IAmPattycakes/AdvancedPrototypingHandheld/Pictures/IMG_20180402_155633.jpg

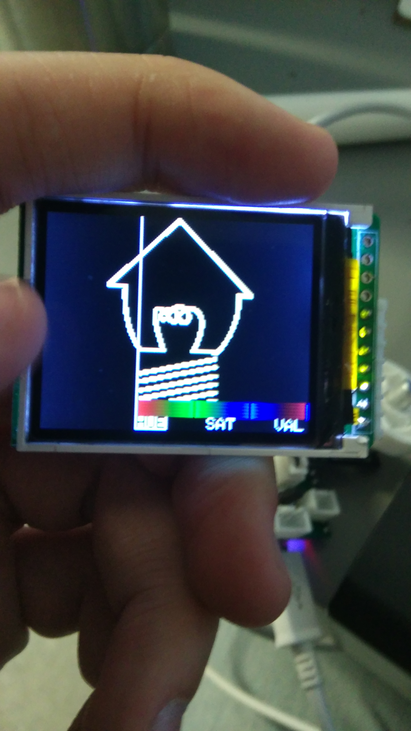
Pictures/IMG_20180402_155633.jpg
