IAmPattycakes/AdvancedPrototypingHandheld/README.txt

Hello World

This is a GitHub repository for the CRT 420 Advanced Prototyping Class
