IAmPattycakes/AdvancedPrototypingHandheld/Documentation/00 - Project Poster.pdf

# Photo-Home

# CRT 420 - Spring 2018

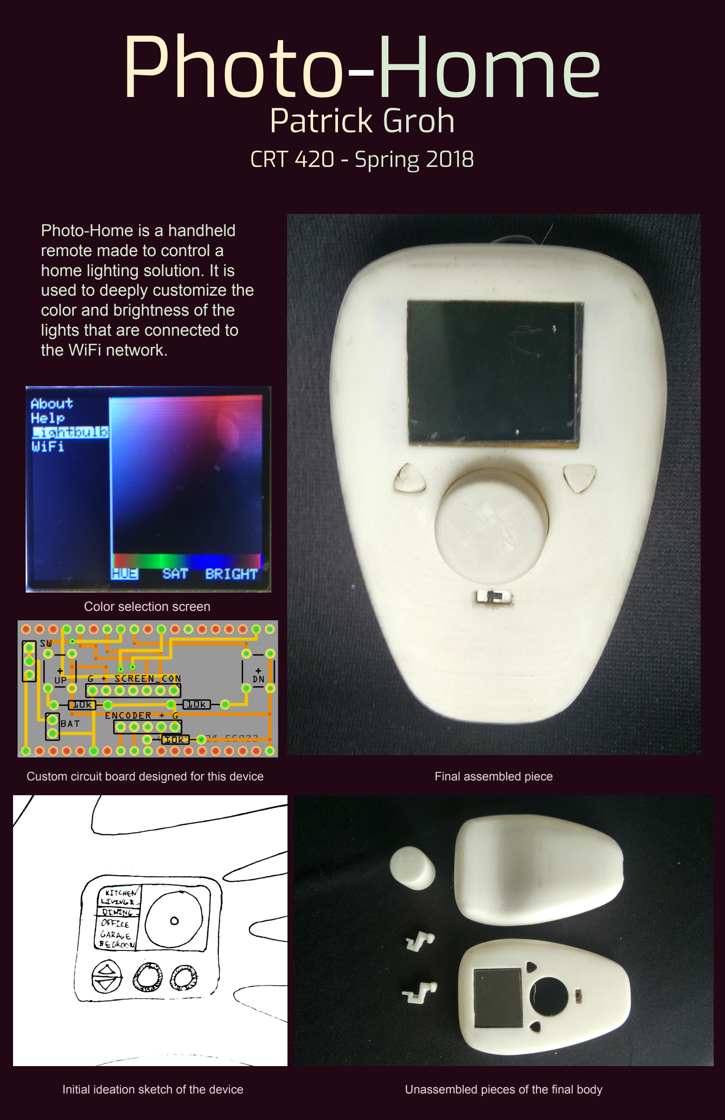
[picture p2: page 1]

Photo-Home is a handheld
remote made to control a
home lighting solution. It is used to deeply customize the color and brightness of the lights that are connected to the WiFi network.

# Patrick Groh

Color selection screen

Custom circuit board designed for this device

Initial ideation sketch of the device

Final assembled piece

Unassembled pieces of the final body
