IAmPattycakes/AdvancedPrototypingHandheld/Documentation/07 - Function Production.pdf

## Function Production

### Finalized Software

I have included the following libraries:
- RotaryEncoder by Matthias Hertel
- Adafruit GFX
- TFT_eSPI by Bodmer
- And the built in libraries:
- SPI
- EEPROM
- Wifi
- WifiMulti
- HTTPClient

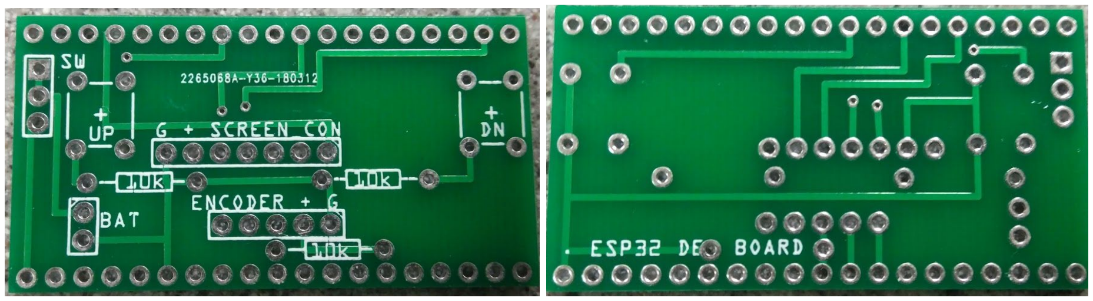
[picture p14: figure]
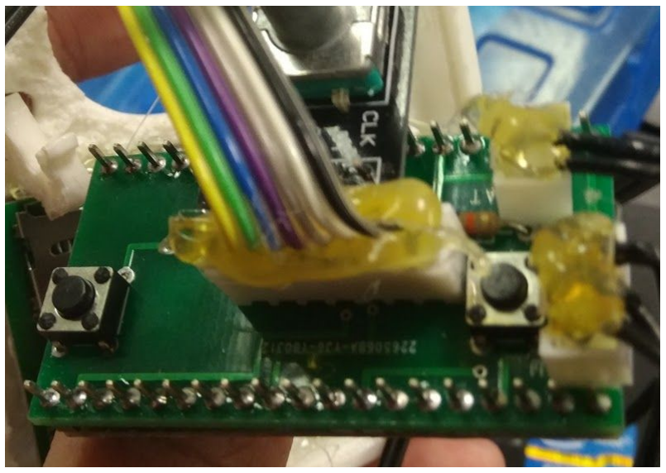
[picture p15: figure]
