IAmPattycakes/AdvancedPrototypingHandheld/Documentation/Pinups/Pinup III.pdf

# Pinup III

## Revenge of the pins

By Patrick Groh

## Board Overview

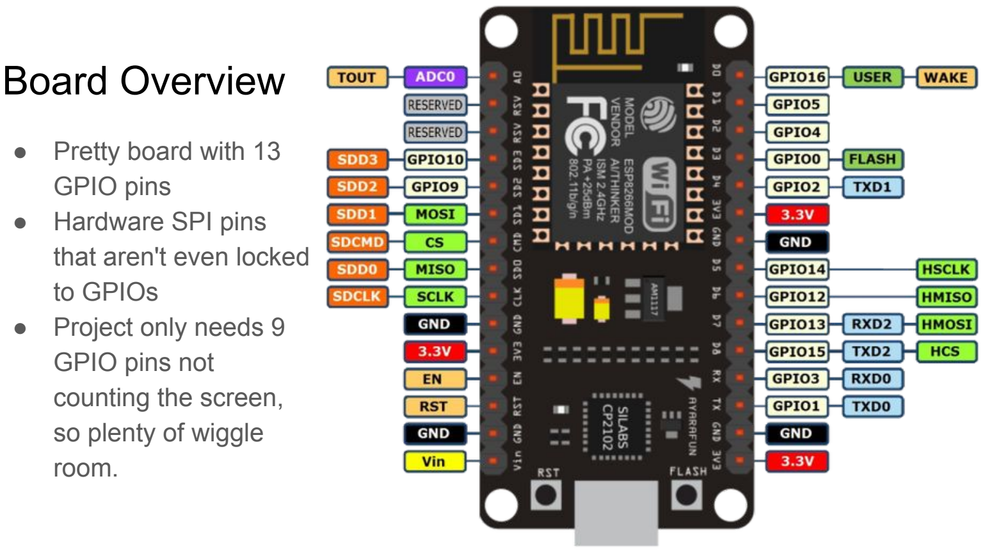
[picture p22: page 2]

- Pretty board with 13
GPIO pins
- Hardware SPI pins
that aren't even locked
to GPIOs
- Project only needs 9
GPIO pins not
counting the screen,
so plenty of wiggle
room.

## Updated board overview

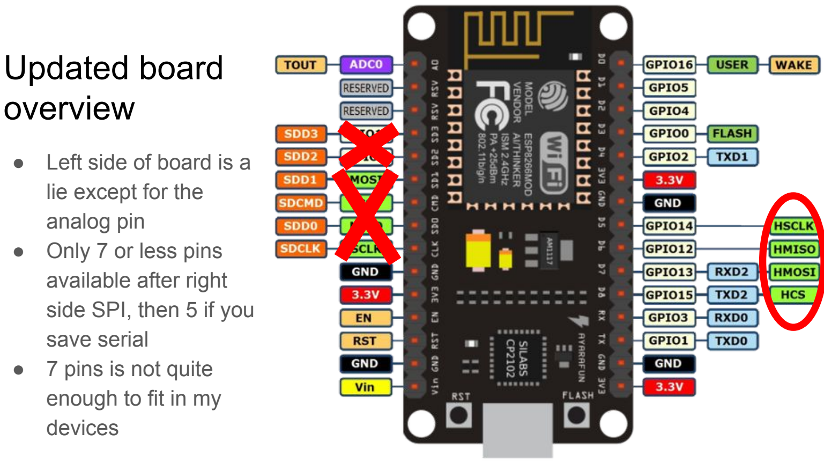
[picture p23: page 3]

- Left side of board is a
lie except for the
analog pin
- Only 7 or less pins
available after right
side SPI, then 5 if you
save serial
- 7 pins is not quite
enough to fit in my
devices

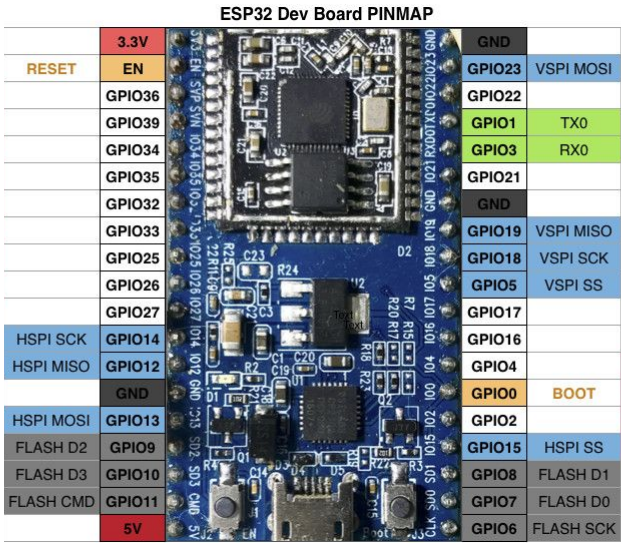
[picture p24: figure]

## Pinout of Replacement (hopefully)

- 15 GPIO pins that are not used for anything critical
- Has same wireless possibilities as ESP8266
- Still small enough to fit in a remote

## Other possibilities:

- Maybe multiplexing the encoders is possible. Maybe.
- Complete, un-user-friendly rework of the UI to save 2 pins
- Daughter board for the screen that drives it over serial cues

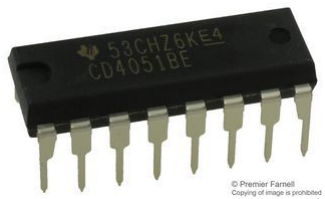
[picture p25: figure]

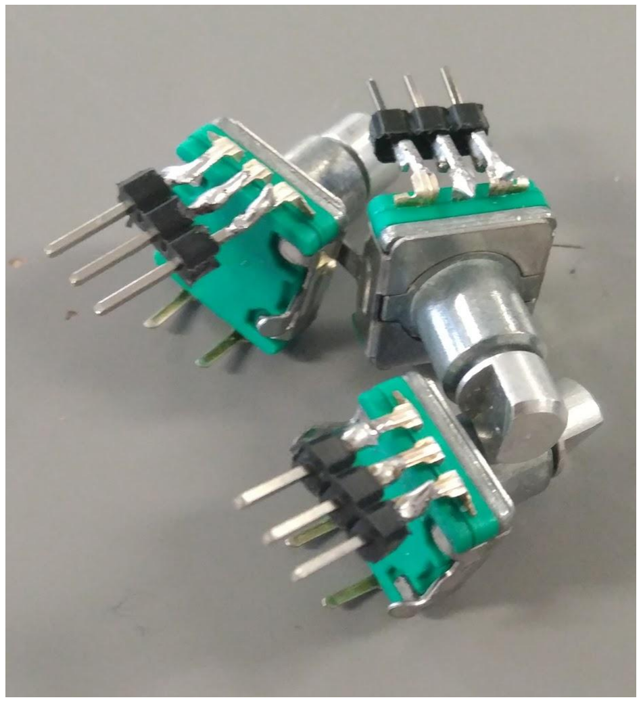
[picture p26: figure]

## Other things that have happened:

- Attempted to Hello World the smaller encoders (Failed)
- Attempted to Hello World web communication to and from the device (Great Success)
- Attempted to Hello World buttons (Success)
- Worked on the program to get things started for the interface
- Made pretty logo concept, to be refined.

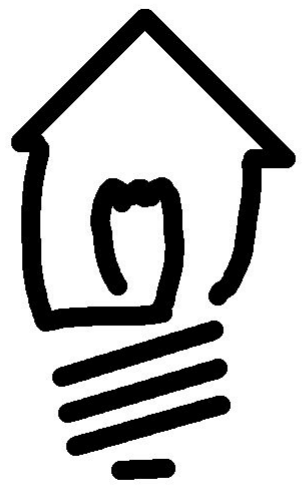
[picture p27: figure]

## Pretty monochrome logo

- Looks kinda like a lightbulb
- Looks kinda like a house
- Artsy
