IAmPattycakes/AdvancedPrototypingHandheld/Documentation/08- Form Production.pdf

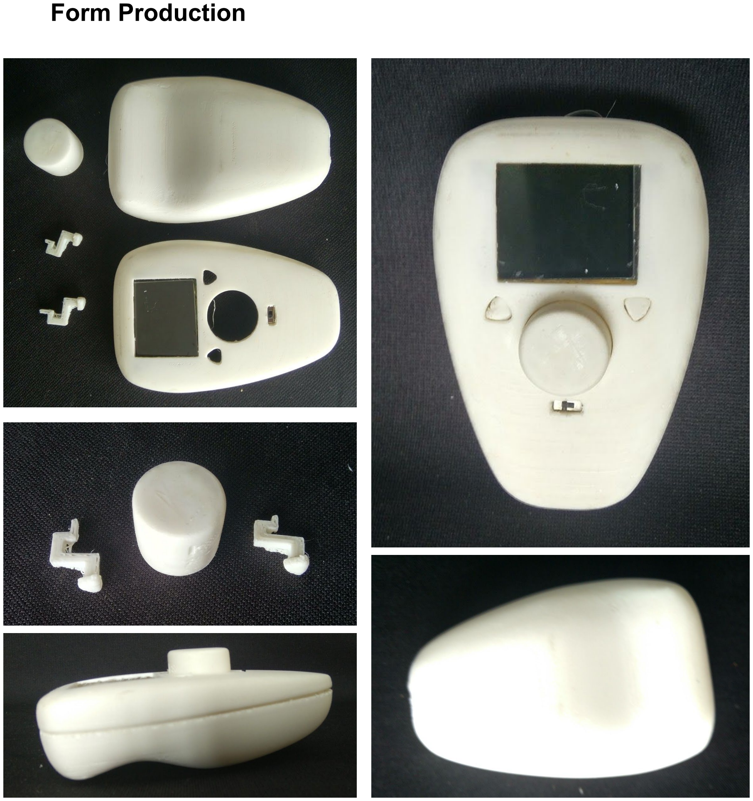
[picture p35: page 1]

Form Production
