IAmPattycakes/AdvancedPrototypingHandheld/Documentation/09-Finalization.pdf

### Finalization

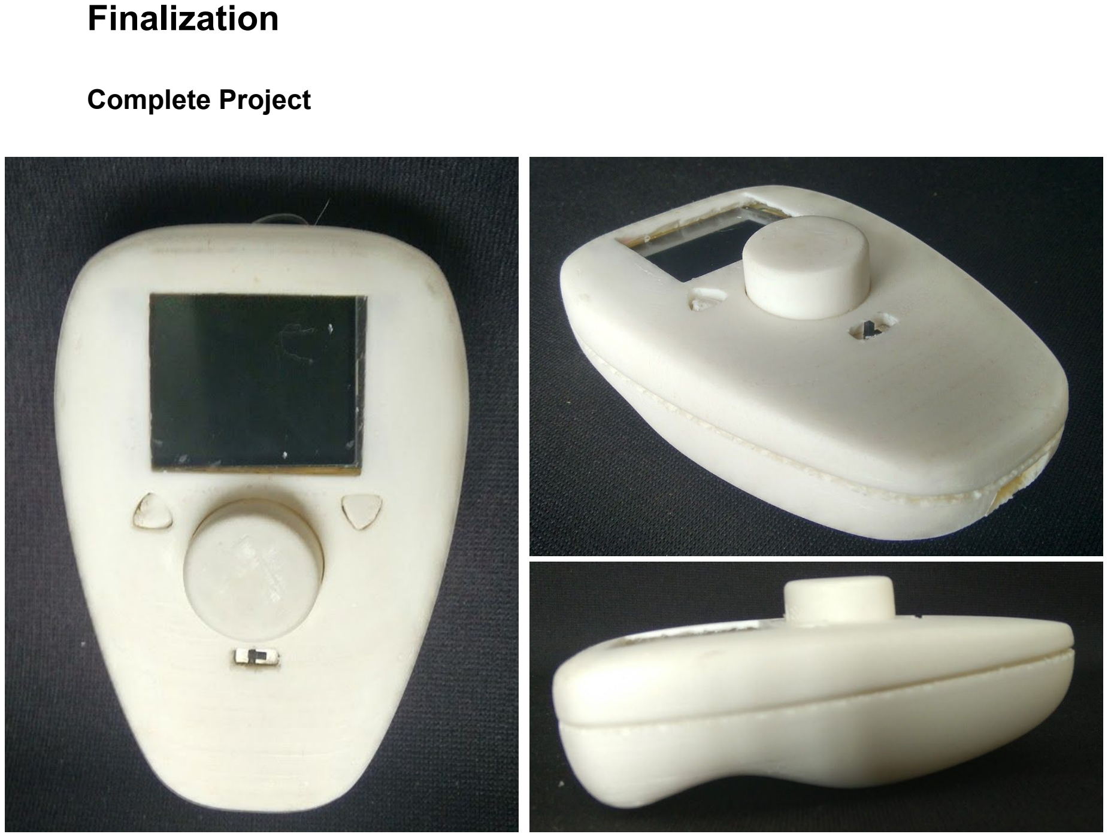
[picture p36: page 1]

Complete Project
