IAmPattycakes/AdvancedPrototypingHandheld/Documentation/06 - Form Proof.pdf

## Form Proof of Concept

Refined Dimensioned Sketches

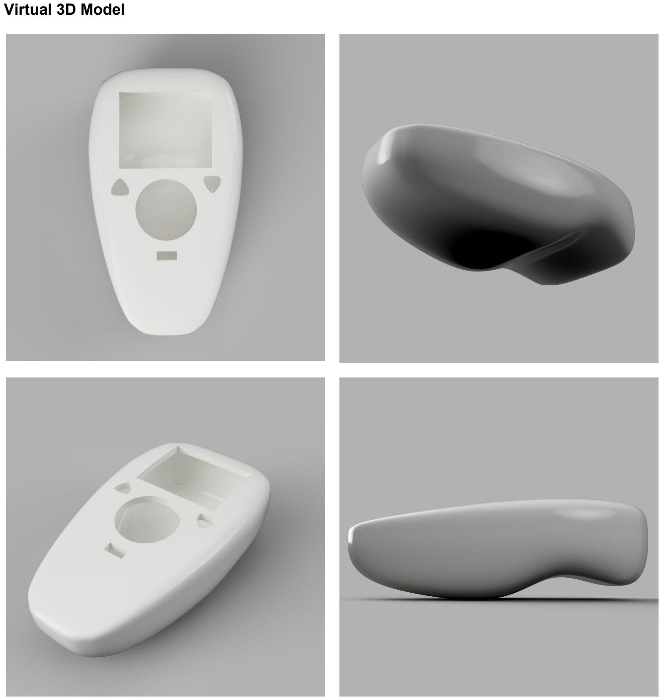
[picture p37: page 2]

Virtual 3D Model

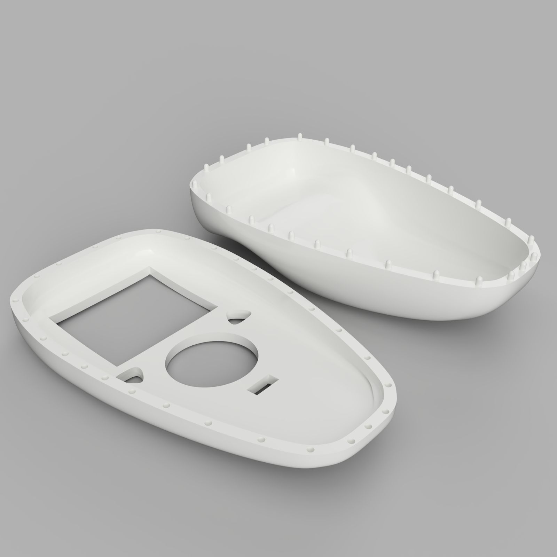
[picture p38: figure]
