IAmPattycakes/AdvancedPrototypingHandheld/Pictures/FSM mockup.png

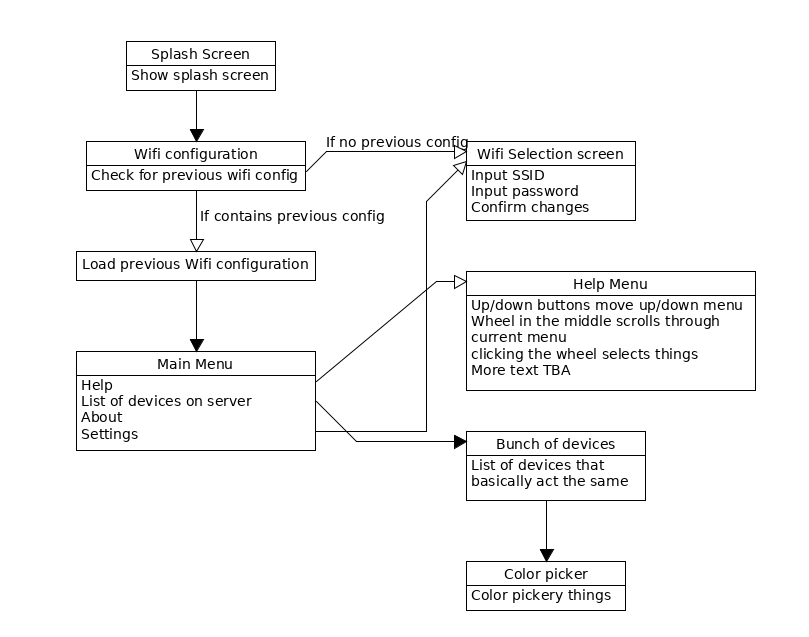
Pictures/FSM mockup.png
