IAmPattycakes/AdvancedPrototypingHandheld/(threads)

Thread 2 (2018-02-07):

03 Feedback

zanecochran, 2018-02-07:
Power - Please use the power management chip that I e-mailed you about.

IAmPattycakes, 2018-02-12:
Updated power management board to the TP5410.

Closed 2018-02-12.
