IAmPattycakes/AdvancedPrototypingHandheld/(list of files, drawings)

Other design files:
PCB Files/Handheld_Main.fzz
