IAmPattycakes/AdvancedPrototypingHandheld/(commit log)

2018-02-12 Updated function development with WIP images for the breadboard model and electronic schematic.
2018-02-12 Updated the power controller to TP5410
2018-02-12 Updated mood board
2018-02-14 Updated breadboard diagram and electronic schematic. Fixed issue with improper labeling of the component sketch.
2018-03-07 Added PCB files directory to root directory Added main board Fritzing file to PCB files directory
    [Handheld_Main.fzz]
